traquito/traquito.github.io/README.md

### This is the repo for the Traquito website

You probably want to look at the website instead of the repo -- https://traquito.github.io

\
\
\
\
\
&nbsp;

#### Note -- No license available

You may use/copy the resources explicitly offered (eg hardware design files, .uf2 firmware), but the contents of this repo are not available for licensing and may not be used without written permission.
