traquito/traquito.github.io/docs/pro/telemetry/extended/playground/README.md

---
icon: material/seesaw
---

# Extended Telemetry Playground

<!DOCTYPE html>
<html>
  <head>
    <meta http-equiv="refresh" content="0; url='/pro/codec" />
  </head>
</html>
