traquito/traquito.github.io/docs/search/spots/dashboard/example/README.md

---
icon: material/map-search-outline
---

# Spot Search Example

<!DOCTYPE html>
<html>
  <head>
    <meta http-equiv="refresh" content="0; url='/search/spots/dashboard/?band=20m&channel=269&callsign=KD2KDD&limit=2000&dtGte=2023-05-08&dtLte=2023-06-01'" />
  </head>
</html>
