traquito/traquito.github.io/docs/updates/index.md

---
icon: material/new-box
---

# Updates
