traquito/traquito.github.io/docs/pro/query/REDIRECT.md

---
icon: material/database-search

hide:
  - toc
---

# Query wspr.live

<!DOCTYPE html>
<html>
  <head>
    <meta http-equiv="refresh" content="0; url='/pro/query'" />
  </head>
</html>
