traquito/traquito.github.io/docs/updates/posts/2023-07-17_19-18-01/2023-07-17_19-18-01.md

---
date:
  created: 2023-07-17

categories:
  - converted
  - site
---

# Better and new graphs, more flight info

!!! note "This entry is based on a converted groups.io post, put here for any documentation value."

Hi,

Minor updates to the website, mostly about graphing.

<strong>Graphs are easier to zoom in/out:</strong>

Just put your mouse over the chart, scroll up to zoom in, scroll down to zoom out, click+drag to pan left or right.

The x-axis automatically adapts to the zoom level.

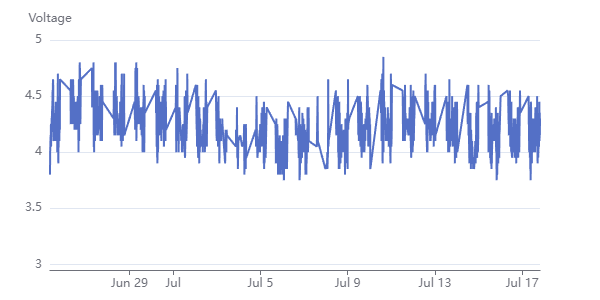
[picture p69: docs/updates/posts/2023-07-17_19-18-01/attach_0_1772D4B480047465_24843.png]


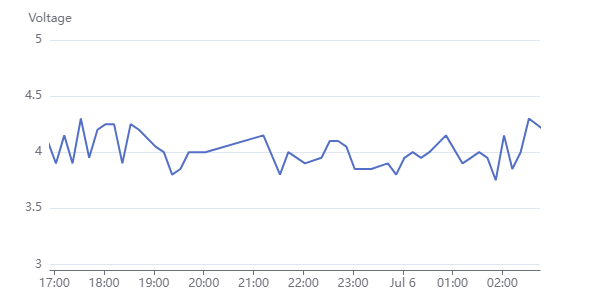
[picture p70: docs/updates/posts/2023-07-17_19-18-01/attach_1_1772D4B48007C552_24843.png]


<strong>Graphs show tooltips with both metric and imperial (and no more double-lines):</strong>

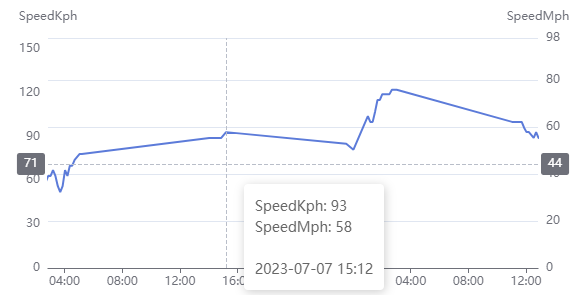
[picture p71: docs/updates/posts/2023-07-17_19-18-01/attach_2_1772D4B48021F60F_24843.png]


<strong>Experimental Graphs (only one for now):</strong>

Underneath the regular graphs is a new expandable section.



At the moment it has a user-configurable scatterplot that lets you (say) compare the temperature to reported voltage.

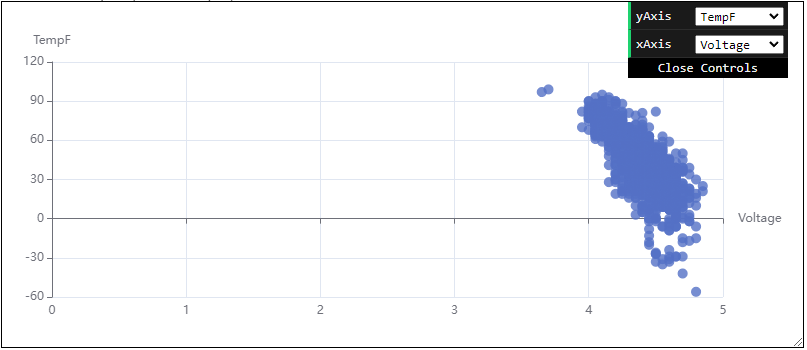
[picture p72: docs/updates/posts/2023-07-17_19-18-01/attach_4_1772D4B4802DD230_24843.png]


You can compare any measurement to any other measurement, however, and the graph just updates its view.

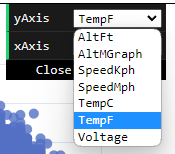
[picture p73: docs/updates/posts/2023-07-17_19-18-01/attach_5_1772D4B48039D973_24843.png]


Here are two searches that have relatively long histories that may be interesting to look at:

<ul>

<li>(<a href="https://traquito.github.io/search/spots/dashboard/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" target="_blank" rel="noopener">link</a>) K6STS</li>

<li>(<a href="https://traquito.github.io/search/spots/dashboard/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" target="_blank" rel="noopener">link</a>) WD0HXN</li>

</ul>

I didn't want to burden the typical page viewer with too much information, but happy to take feedback about what is/isn't useful to see.

<strong>The graphs are much faster to load and snappier to use.</strong>

Can't take a screenshot of that but the page hopefully feels even zippier.

<strong>Info section has more info</strong>

A few additional stats got added.

Flight duration just does the math for you by looking at the earliest and latest spot in your search and working out the difference.



Thanks.

Doug
