traquito/traquito.github.io/docs/README.md

---
icon: material/home

hide:
  - toc
---

# Traquito WSPR Pico Balloon Resources

<div class="grid cards" markdown>

- <a class="card" href="./tracker/">
    <figure markdown="span">
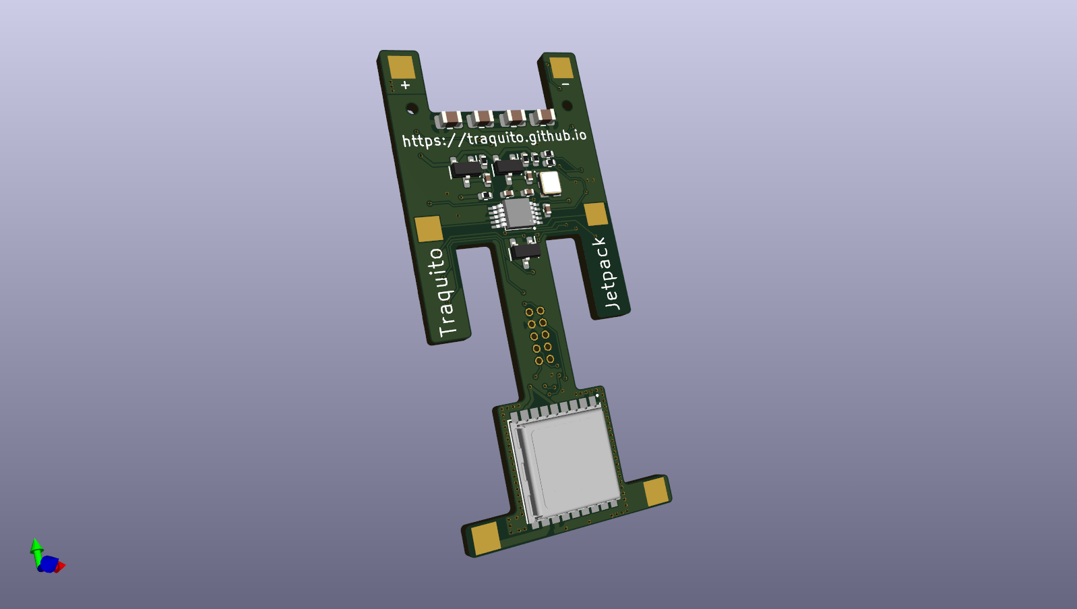
[picture p80: docs/img/tracker.png]
        
        <figcaption>Jetpack WSPR Tracker</figcaption>
    </figure>
  </a>

- <a class="card" href="./solar/">
    <figure markdown="span">
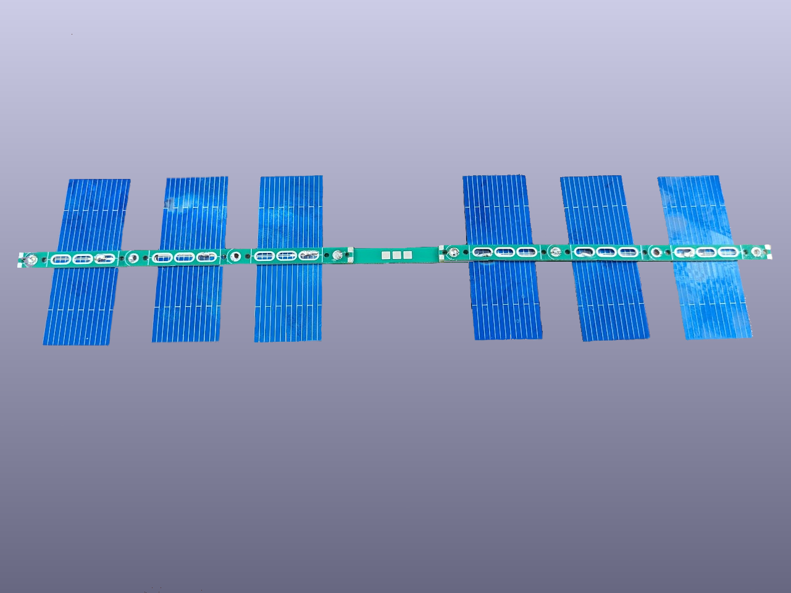
[picture p81: docs/solar/solar.png]
        
        <figcaption>Solar System</figcaption>
    </figure>
  </a>

- <a class="card" href="./search/spots/dashboard/example/" target="_blank">
    <figure markdown="span">
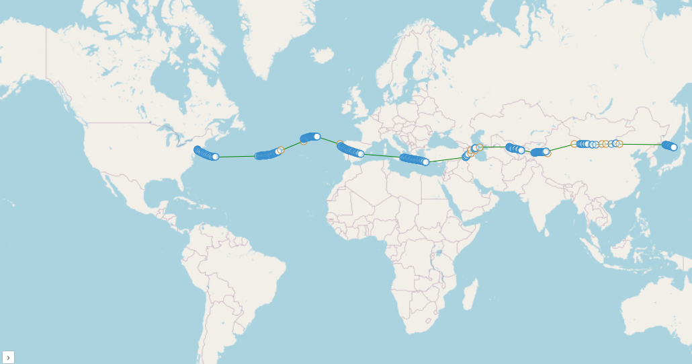
[picture p82: docs/img/spotsearch.png]
        
        <figcaption>Spot Search</figcaption>
    </figure>
  </a>

- <a class="card" href="./channelmap/">
    <figure markdown="span">
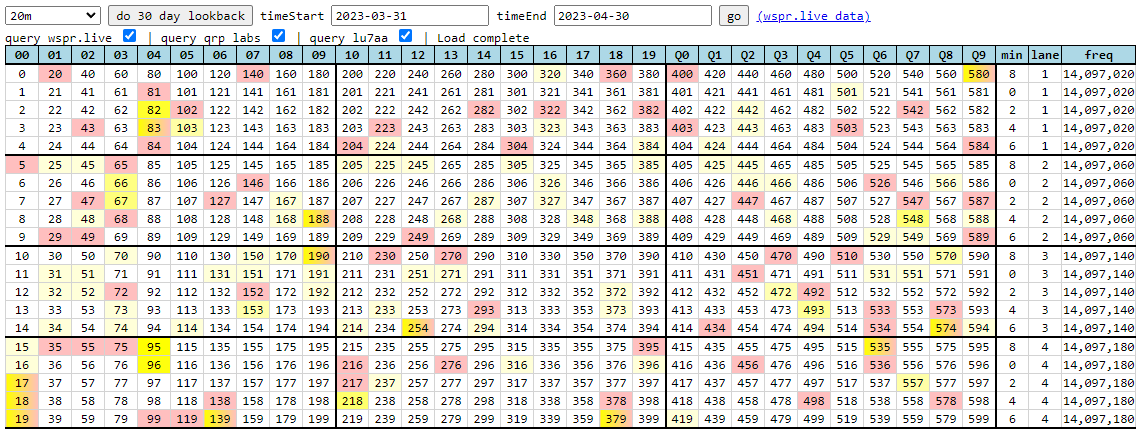
[picture p83: docs/img/channelmap.png]
        
        <figcaption>Channel Map</figcaption>
    </figure>
  </a>

- <a class="card" href="./trackergui/">
    <figure markdown="span">
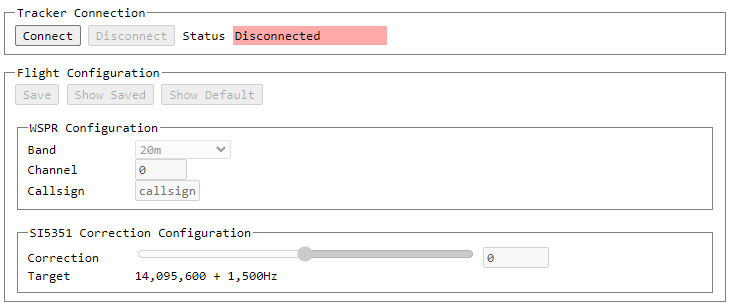
[picture p84: docs/img/trackergui.png]
        
        <figcaption>Tracker GUI</figcaption>
    </figure>
  </a>

- <a class="card" href="./WOM5000/">
    <figure markdown="span">
        
        <figcaption>Wind-O-Matic 5000</figcaption>
    </figure>
  </a>

- <a class="card" href="./pro/">
    <figure markdown="span">
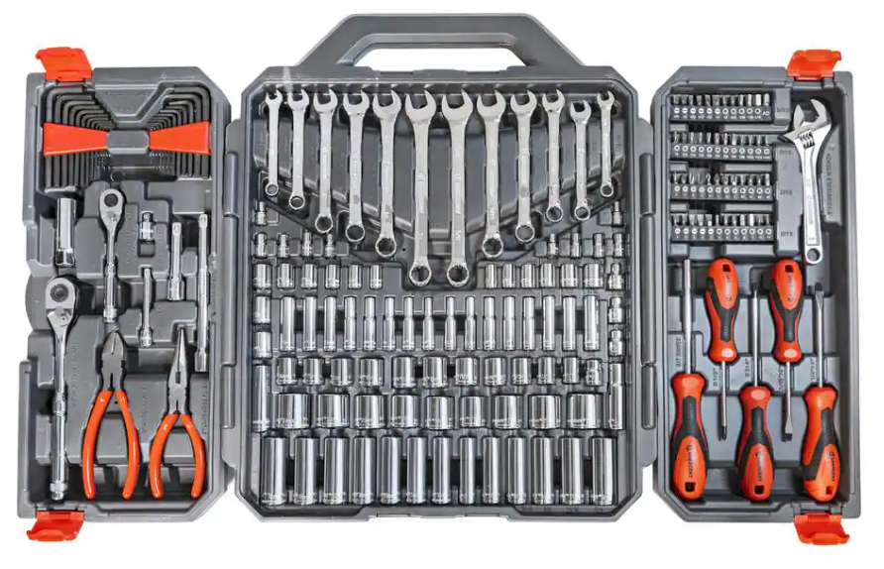
[picture p85: docs/img/protools.png]
        
        <figcaption>Pro Tools</figcaption>
    </figure>
  </a>

- <a class="card" href="./updates/">
    <figure markdown="span">
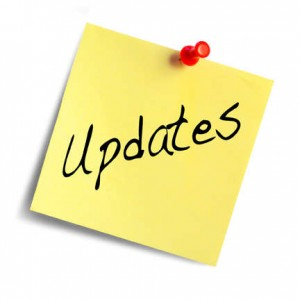
[picture p86: docs/updates/card.jpg]
        
        <figcaption>Updates</figcaption>
    </figure>
  </a>

- <a class="card" href="./faq/">
    <figure markdown="span">
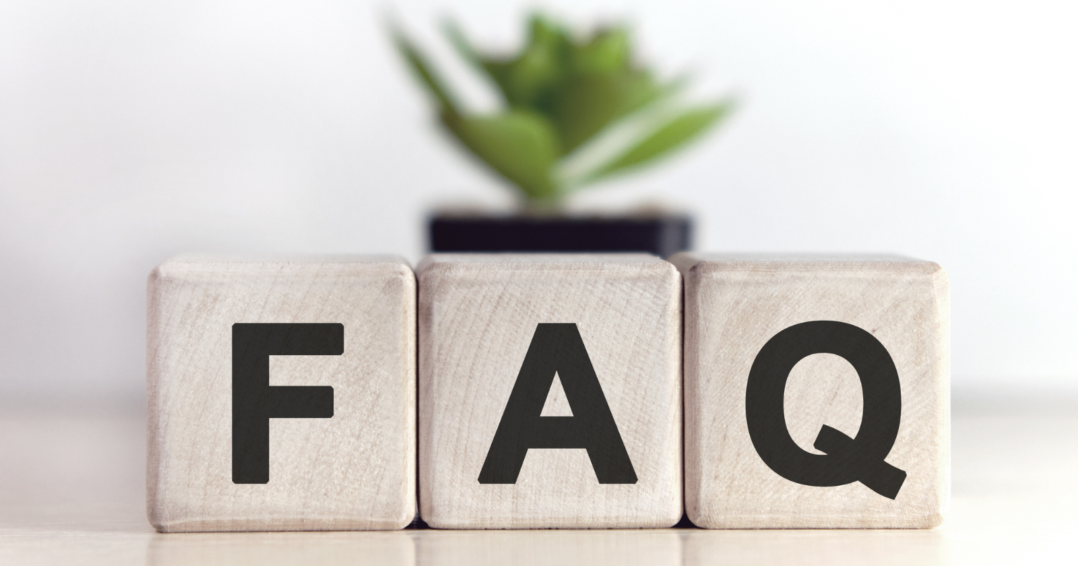
[picture p87: docs/img/faq.png]
        
        <figcaption>FAQ</figcaption>
    </figure>
  </a>

</div>
