traquito/traquito.github.io/docs/pro/README.md

---
icon: material/professional-hexagon

hide:
  - toc
---

# Pro Tools

<div class="grid cards" markdown>

- <a class="card" href="./decode/">
    <figure markdown="span">
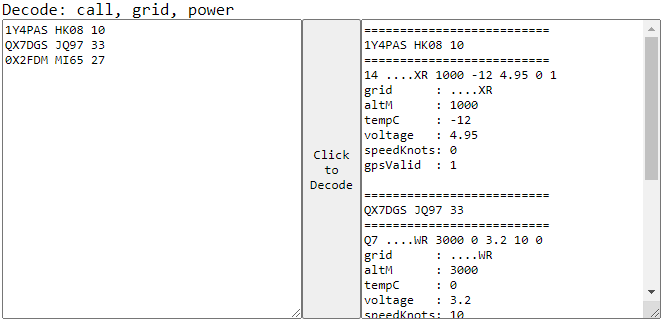
[picture p88: docs/pro/decode/decode.png]
        
        <figcaption>Decode</figcaption>
    </figure>
  </a>

- <a class="card" href="./query/">
    <figure markdown="span">
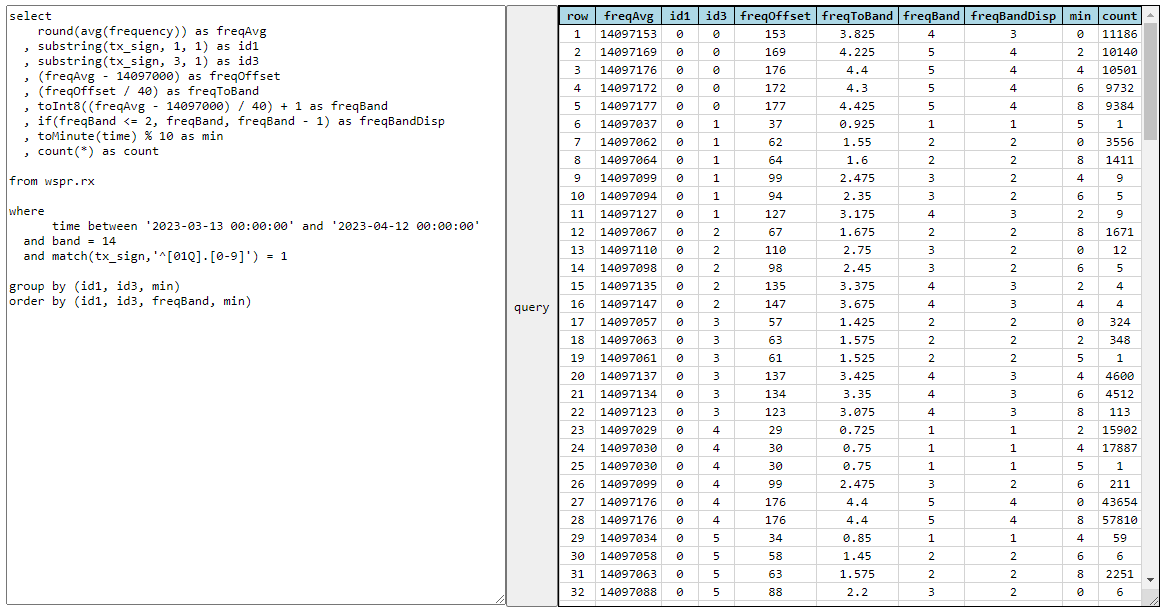
[picture p89: docs/pro/query/query.png]
        
        <figcaption>Query</figcaption>
    </figure>
  </a>

- <a class="card" href="./apimode/">
    <figure markdown="span">
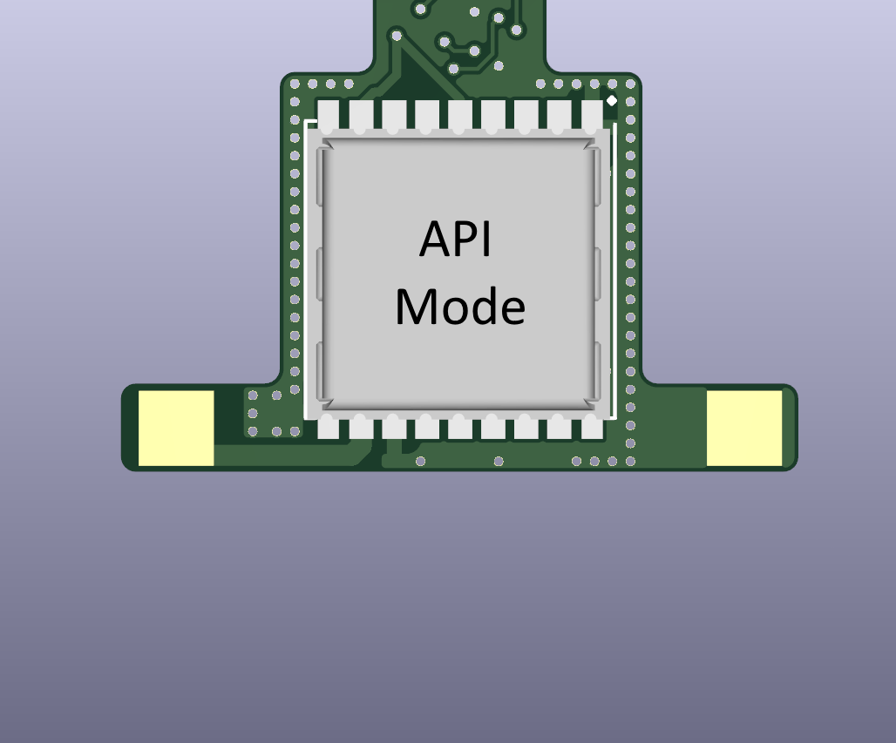
[picture p90: docs/pro/apimode/apimode.png]
        
        <figcaption>API Mode</figcaption>
    </figure>
  </a>

- <a class="card" href="./trackerhacker/">
    <figure markdown="span">
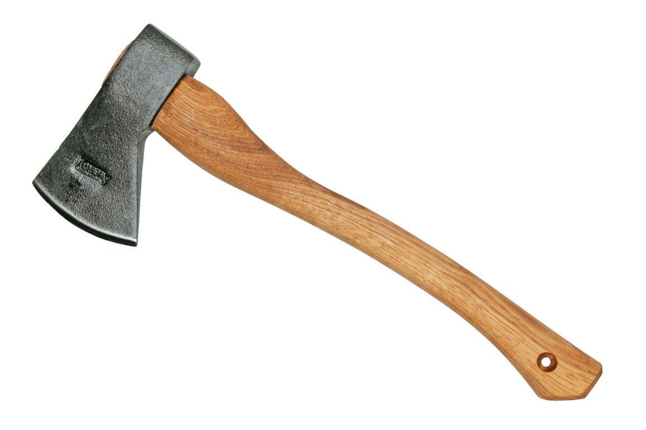
[picture p91: docs/pro/trackerhacker/trackerhacker.png]
        
        <figcaption>Tracker Hacker</figcaption>
    </figure>
  </a>

- <a class="card" href="./telemetry/">
    <figure markdown="span">
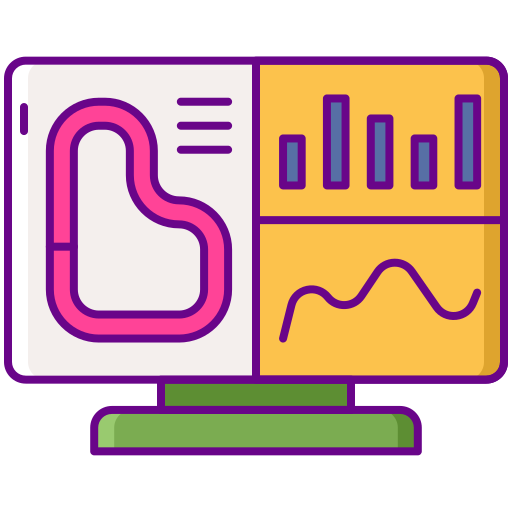
[picture p92: docs/pro/telemetry/card.png]
        
        <figcaption>WSPR Telemetry</figcaption>
    </figure>
  </a>

</div>
