traquito/traquito.github.io/docs/updates/posts/2023-11-12_12-02-10/2023-11-12_12-02-10.md

---
date:
  created: 2023-11-12

categories:
  - converted
  - site
---

# Jump between map and data

!!! note "This entry is based on a converted groups.io post, put here for any documentation value."

Hi, a few new features to mention.

It's all about page interactivity.

<strong><span style="text-decoration: underline;">Focus the map from the graph</span></strong>

When you hover over a graph, you see a tooltip showing you the date/time of where your cursor is.

Now, when you click any graph at a given time, the map will center on that spot and pop-up the info dialog.

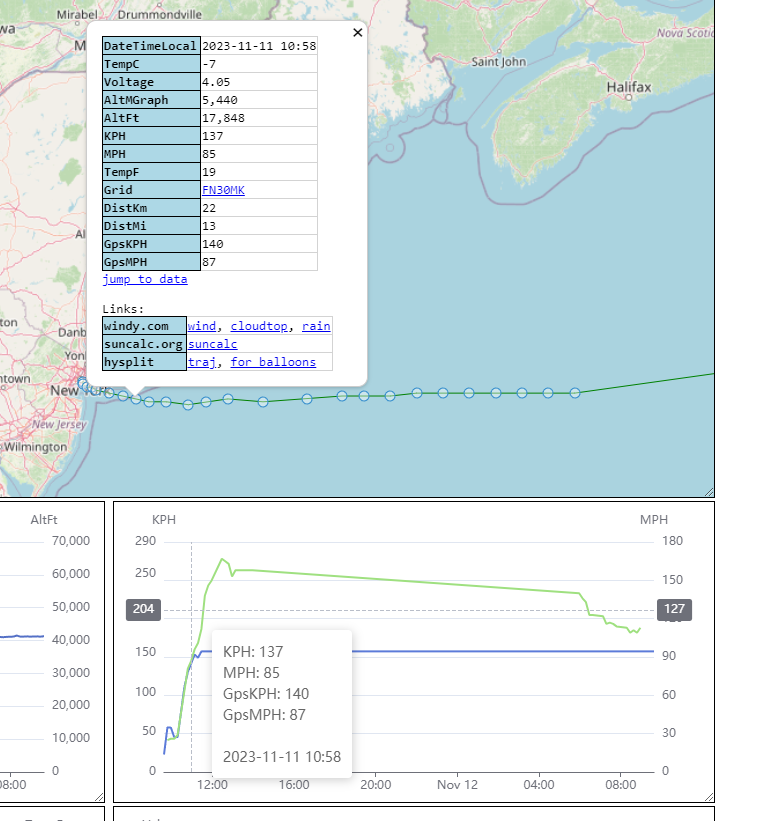
[picture p108: docs/updates/posts/2023-11-12_12-02-10/attach_0_1796F8ACF072FA6D_7701.png]


<strong><span style="text-decoration: underline;">Focus the map from data</span></strong>

A new "Map" column has been added with a link per-row.

Click the link, and the page will jump to the map, and the map will center on that spot and pop-up the info dialog.

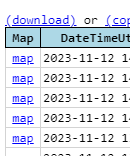
[picture p109: docs/updates/posts/2023-11-12_12-02-10/attach_1_1796F8ACF07C3EBF_7701.png]


<strong><span style="text-decoration: underline;">Jump to data from map</span></strong>

A new "jump to data" link is visible in the map spot pop-up.

Click the link, and the page will jump to the data.



<strong><span style="text-decoration: underline;">Generally</span></strong>

The idea is that it can be hard to look at data and find the corresponding map location, and vise versa, especially when looking at long flights.

Hopefully this makes exploring the data a little easier.

Example long flight:

<a href="https://traquito.github.io/search/spots/dashboard/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" target="_blank" rel="noopener">https://traquito.github.io/search/spots/dashboard/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</a>

Thanks.

Doug
