traquito/traquito.github.io/docs/updates/posts/2024-02-20_11-08-56/2024-02-20_11-08-56.md

---
date:
  created: 2024-02-20

categories:
  - converted
  - site
---

# Toggle map lines

Update,

Map now allows you to turn on/off the lines connecting spots.

Toggled on:

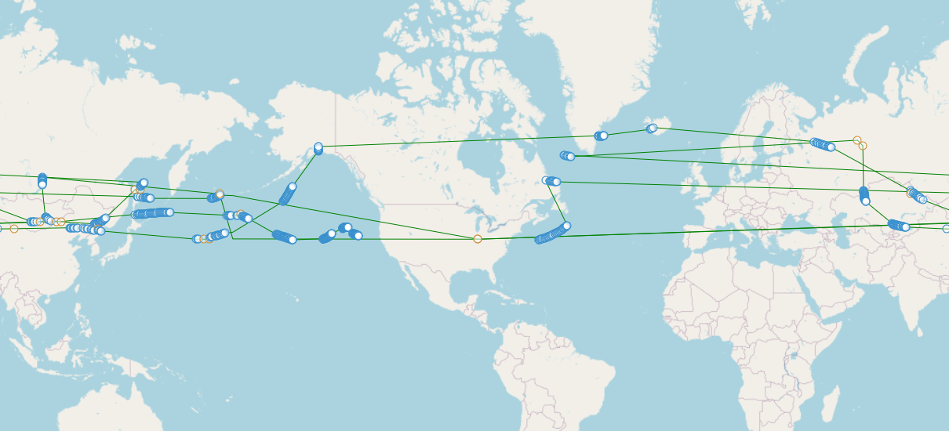
[picture p112: docs/updates/posts/2024-02-20_11-08-56/image.png]


Toggled off:

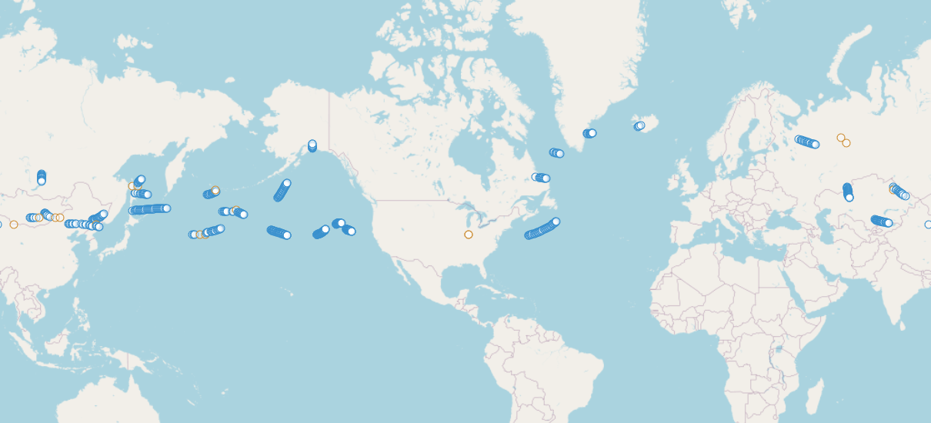
[picture p113: docs/updates/posts/2024-02-20_11-08-56/image-1.png]


The toggle is the "L" button in the upper-right hand corner.



This is based on the request from John about his flight (pictured above, linked [here](https://traquito.github.io/search/spots/dashboard/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)) having long durations of missing data, and the lines connecting them making the path appear incorrect.

The logic for lines is just "connect the dots."  When there are many missing data points, this can lead to the situation above.

Thanks.

Doug
