traquito/traquito.github.io/site/channelmap/help/channels.png

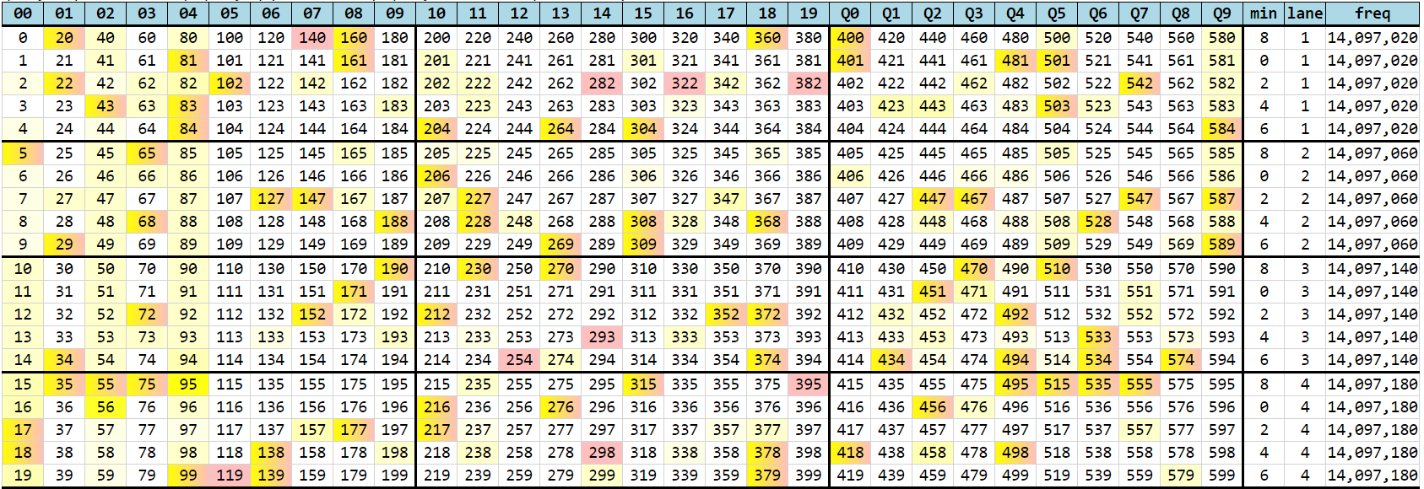
site/channelmap/help/channels.png
