traquito/traquito.github.io/site/pro/trackerhacker/side_by_side.png

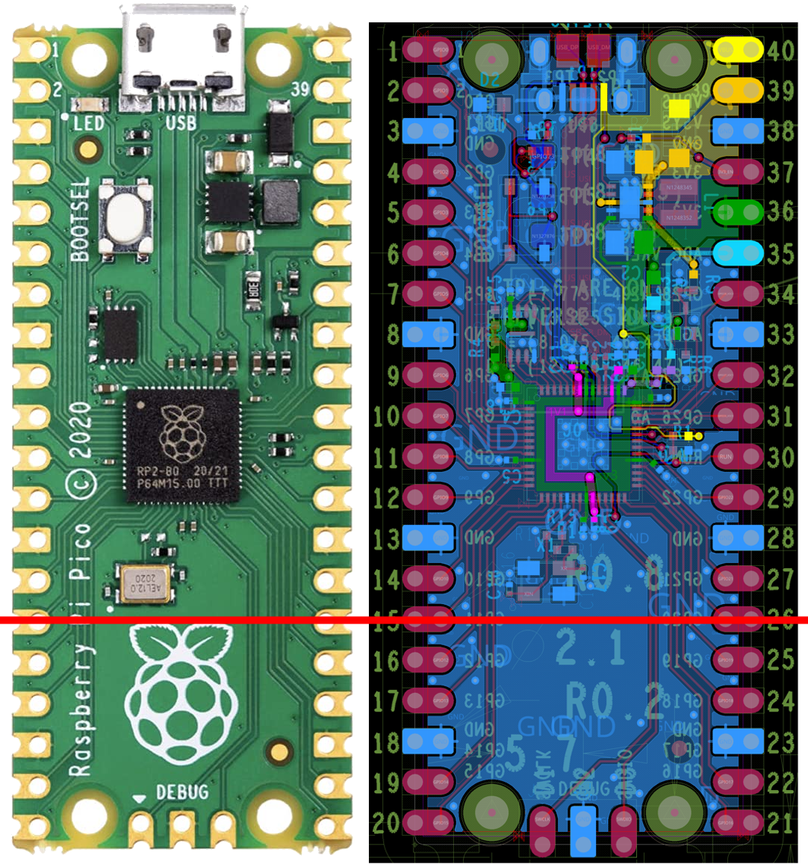
site/pro/trackerhacker/side_by_side.png
