traquito/traquito.github.io/site/solar/battery.png

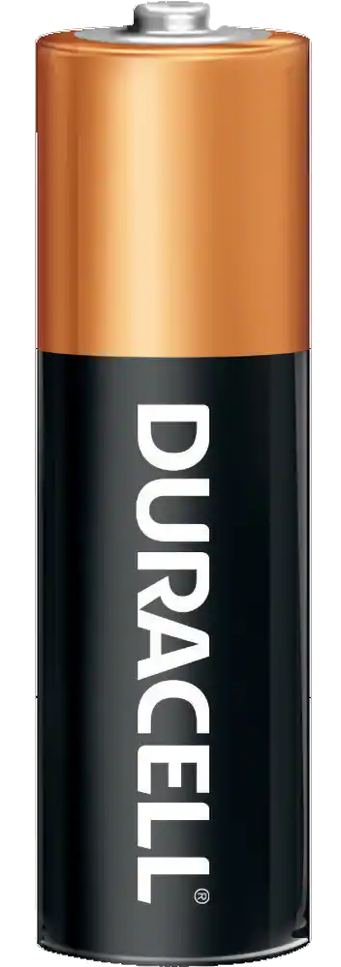
site/solar/battery.png
