traquito/traquito.github.io/site/solar/ss_cells_in_series_bottom.png

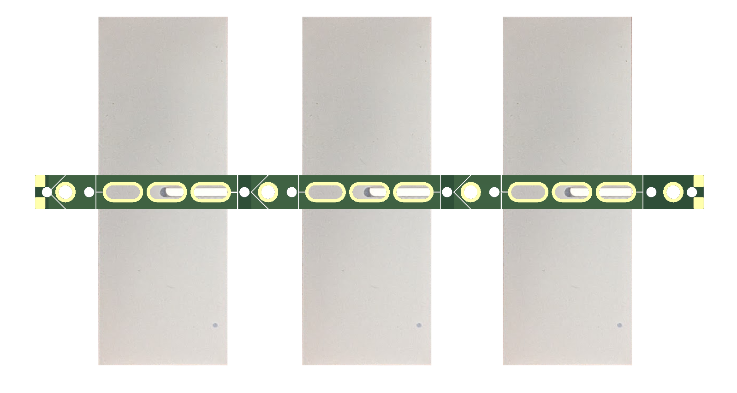
site/solar/ss_cells_in_series_bottom.png
