traquito/traquito.github.io/site/tracker/V1/files/placement.png

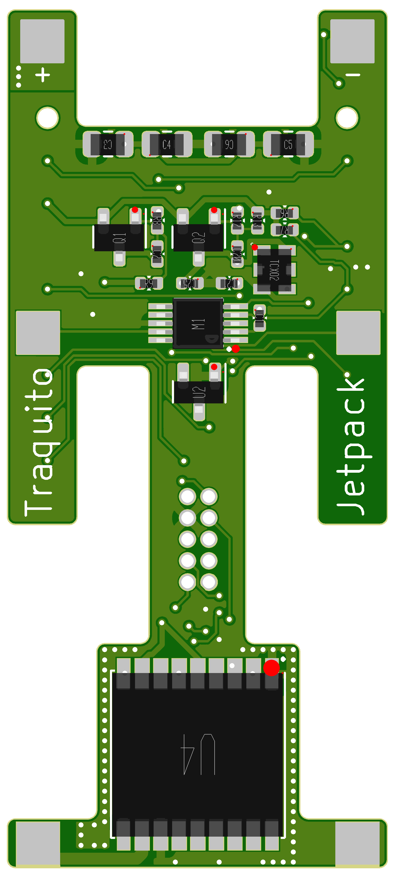
site/tracker/V1/files/placement.png
