traquito/traquito.github.io/site/trackergui/warning.png

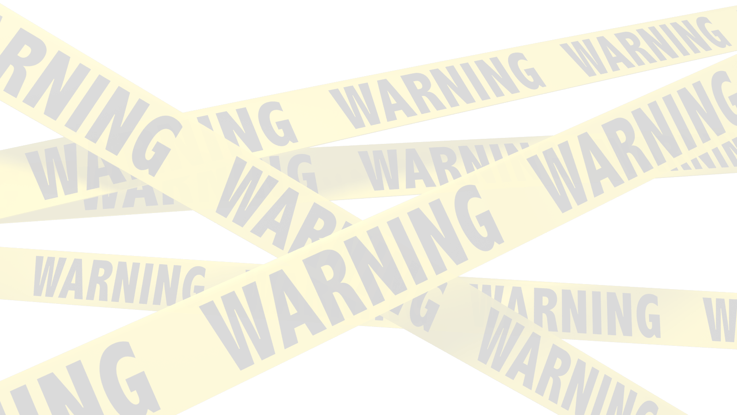
site/trackergui/warning.png
