traquito/traquito.github.io/site/updates/2024-11-30/image-5.png

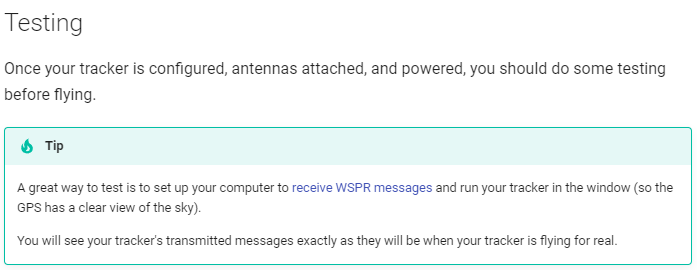
site/updates/2024-11-30/image-5.png
