traquito/traquito.github.io/site/updates/2024-11-30/image-7.png

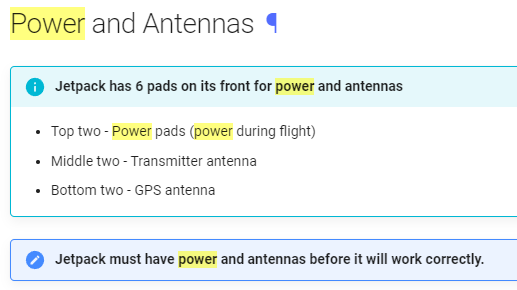
site/updates/2024-11-30/image-7.png
