traquito/traquito.github.io/site/WOM5000/circuit_fritzing.png

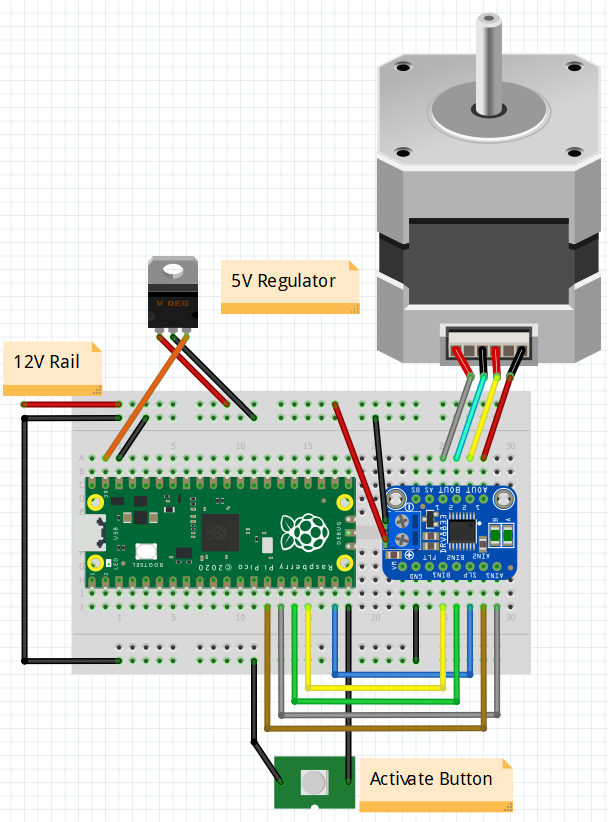
site/WOM5000/circuit_fritzing.png
