traquito/traquito.github.io/site/solar/Solar_System_Soldering_Jig_2024-01-01.stl

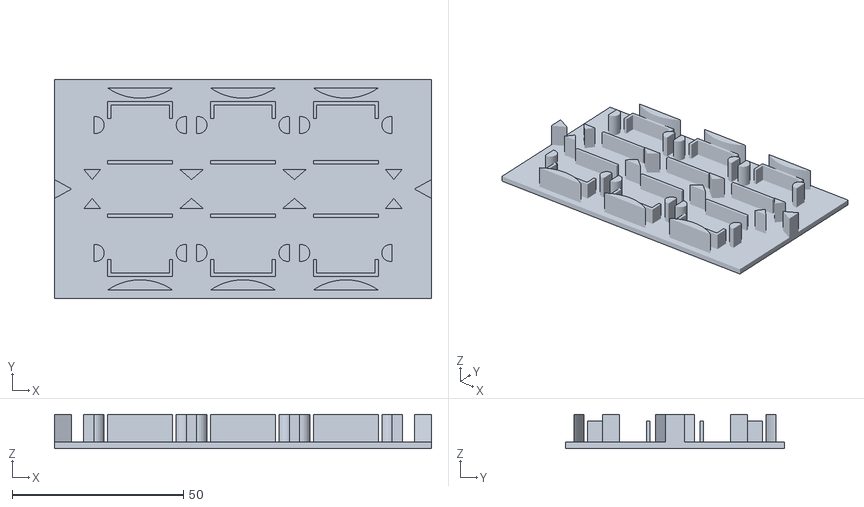
[picture p138: CAD file, 2024-01-01]
site/solar/Solar_System_Soldering_Jig_2024-01-01.stl
110.0 x 64.0 x 10.0
