traquito/traquito.github.io/site/WOM5000/WOM5000.drum.2024-01-30.3mf

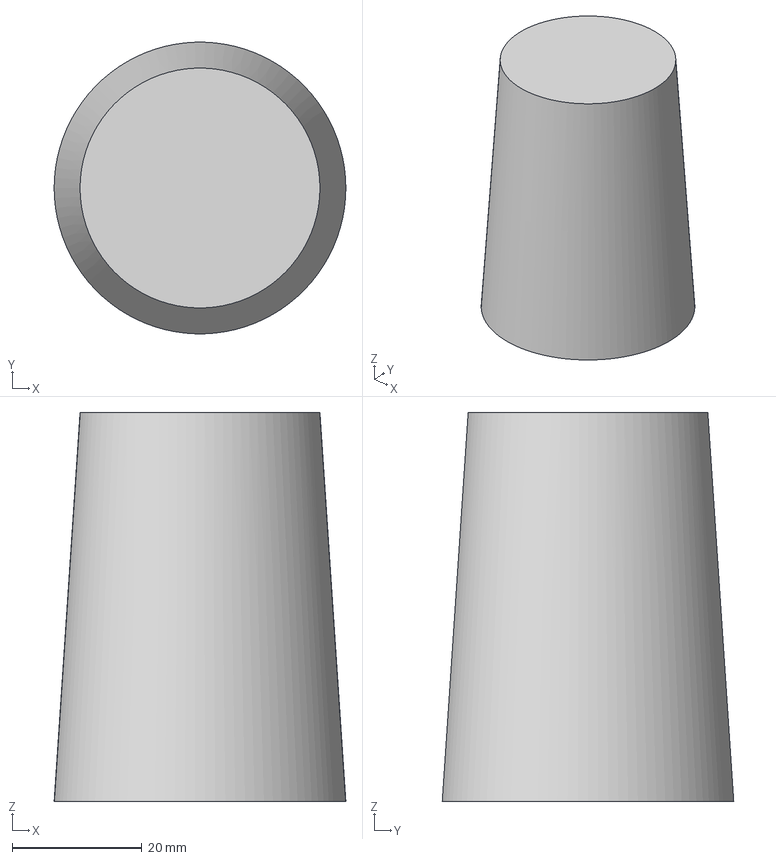
[picture p139: CAD file, 2024-01-30]
site/WOM5000/WOM5000.drum.2024-01-30.3mf
45.0 x 45.0 x 60.0 mm
