traquito/traquito.github.io/site/WOM5000/WOM5000.platform.2024-01-30.3mf

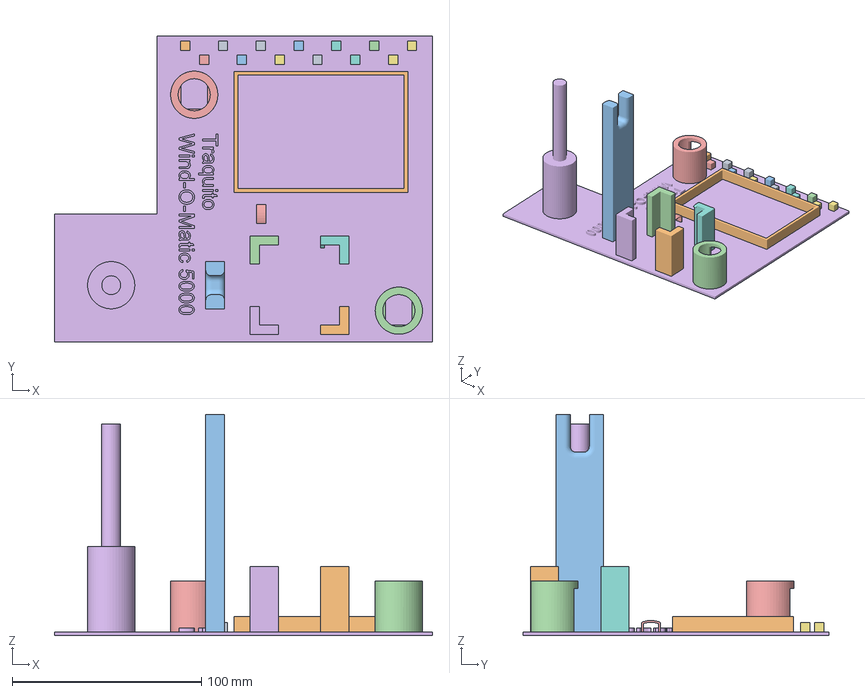
[picture p140: CAD file, 2024-01-30]
site/WOM5000/WOM5000.platform.2024-01-30.3mf
200.0 x 161.8 x 117.0 mm
