traquito/traquito.github.io/docs/faq/jlcpcb/README.md

---
icon: material/chip
---

# Ordering from JLCPCB Instructions

## Ordering from JLCPCB

[jlcpcb.com](https://jlcpcb.com/) fabricates PCBs and assembles them as well, meaning they can produce a fully-populated PCB, shipped directly to you.

The [Traquito Jetpack](../../tracker/README.md#hardware-design-file-downloads) tracker Add-on Module is available to you directly through this service.

There are 3 files you will need to provide to JLCPCB during the ordering process.  You don't need to know anything about these files, just submit them and JLCPCB will take care of the rest.

A walkthrough of how to order is presented below.

!!! info "The set of files used for ordering"
    - BOM ("bill of materials" aka list of parts)
    - CPL part placement file (describes where each component should be placed/soldered on the PCB)
    - Gerber files in a .zip (describes the PCB itself - track location, shape of board, etc)

!!! warning
    The steps below should "just work."

    If you find yourself having to do something unexpected to "get it to work" then something is probably wrong.  Please reach out for help!

!!! tip
    Make sure you have an account created, and that you're logged in, before beginning.

!!! note
    Also, note that JLCPCB sometimes shows the PCB outline as a rectangle, depending on a bug on their side.
    
    The order is fine, though, this is known and you can continue.

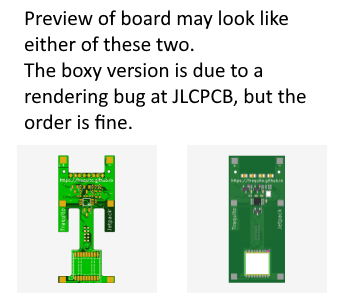
[picture p142: docs/faq/jlcpcb/render_bug.png]
    

### Step 1

[jlcpcb.com](https://jlcpcb.com/)

Drag the gerber zip file onto the circled target on the JLCPCB site.

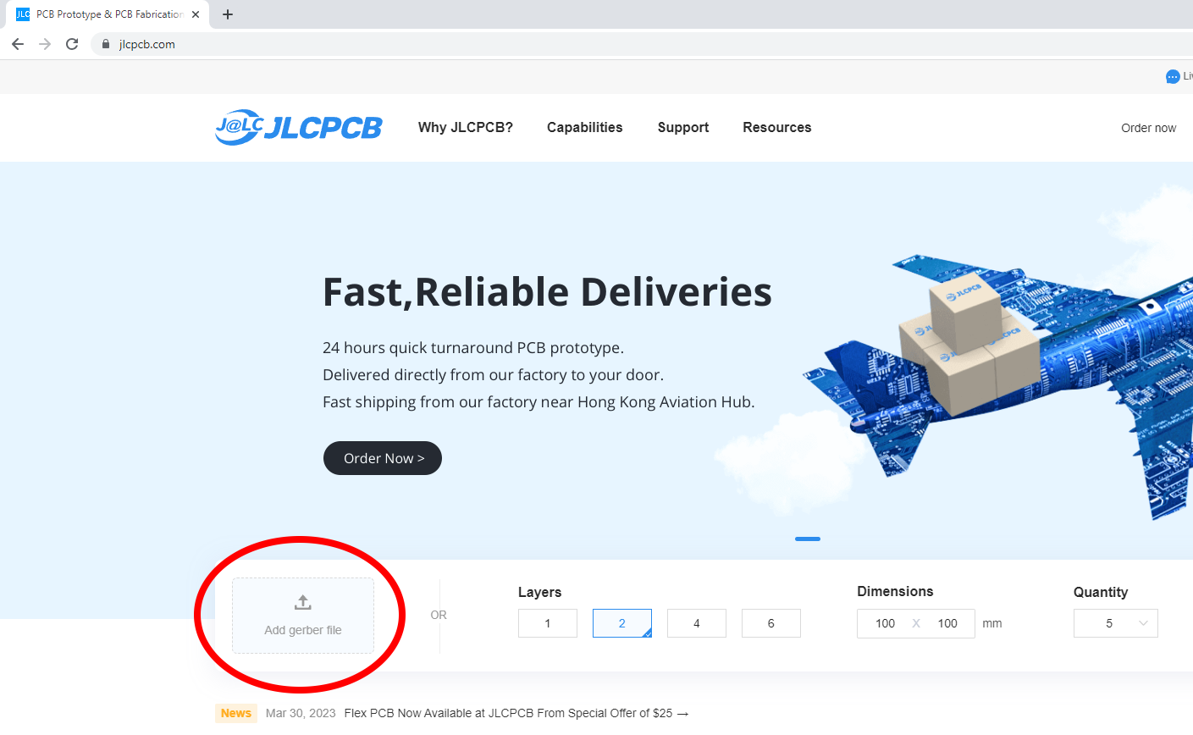
[picture p143: docs/faq/jlcpcb/step1.png]


### Step 2

This page appears and is mostly defaulted correctly.

You only need to change the parts highlighted in red.

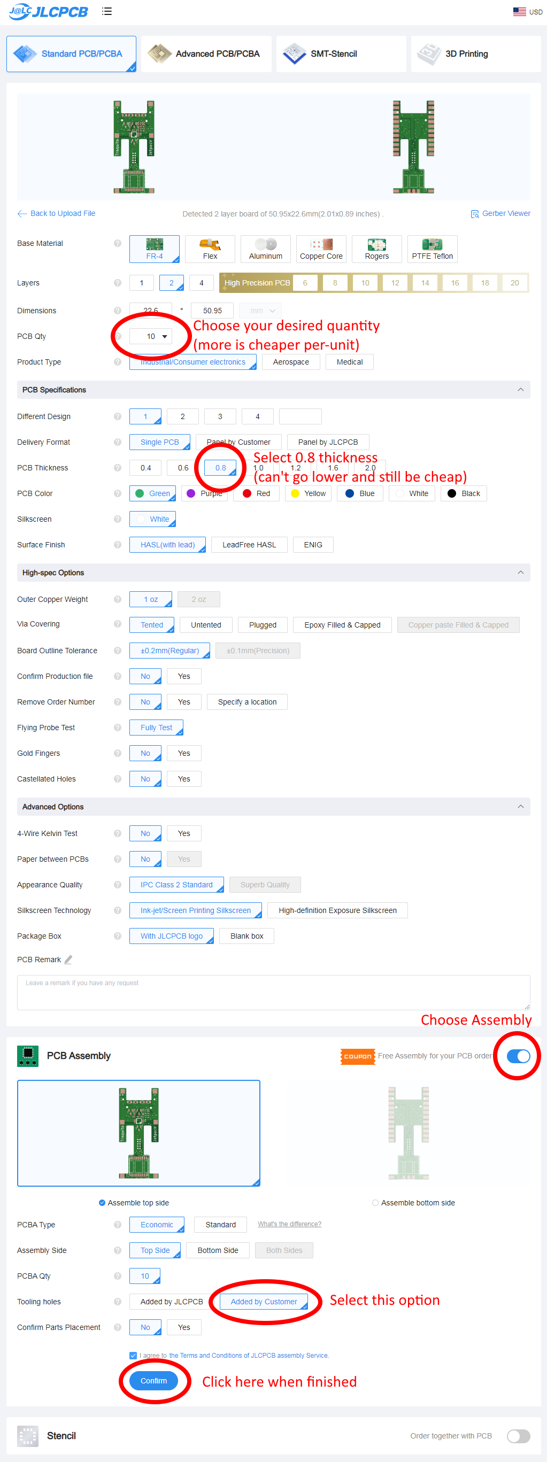
[picture p144: docs/faq/jlcpcb/step2.png]


### Step 3

Click Next.

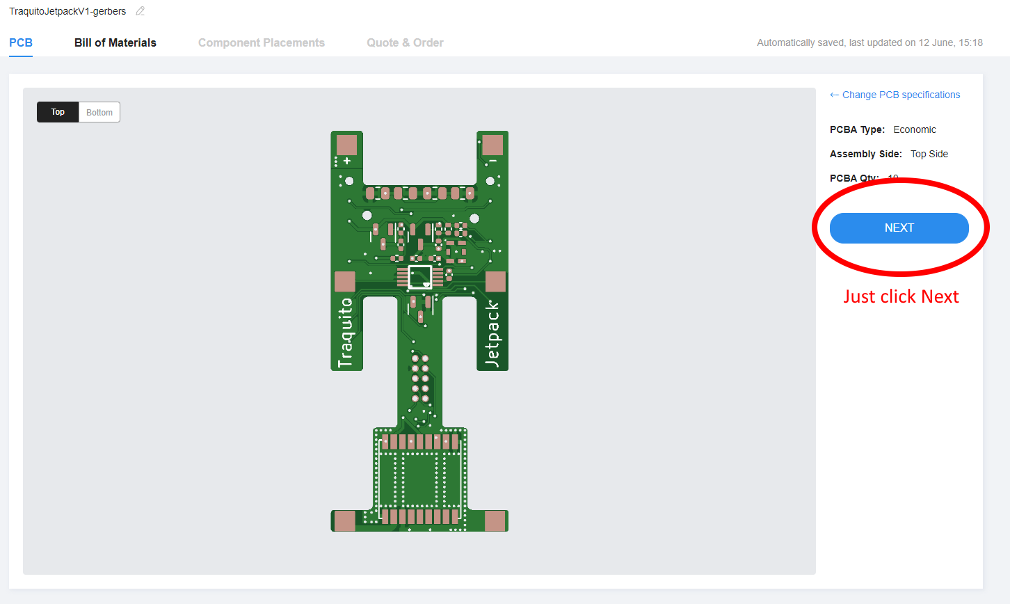
[picture p145: docs/faq/jlcpcb/step3.png]


### Step 4

Provide the BOM and placement files.

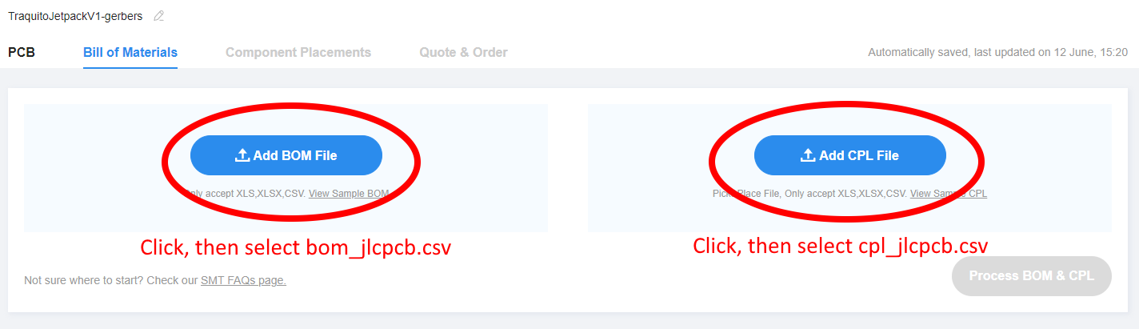
[picture p146: docs/faq/jlcpcb/step4.1.png]


Click to continue when ready.

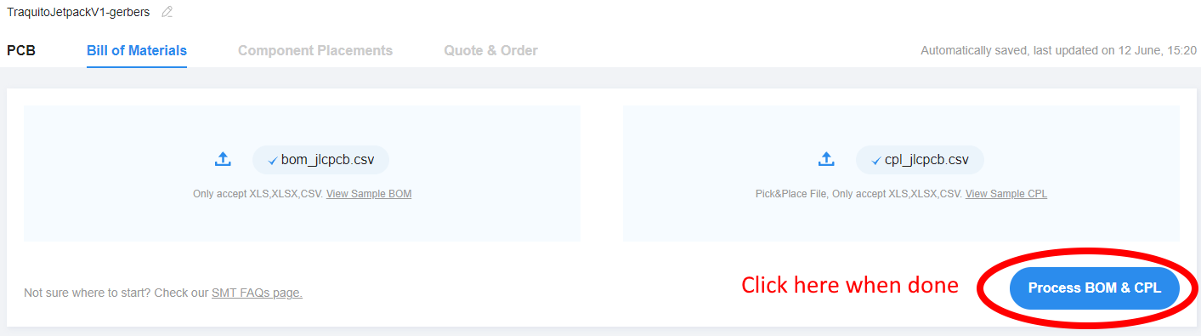
[picture p147: docs/faq/jlcpcb/step4.2.png]


### Step 5

Click Next.

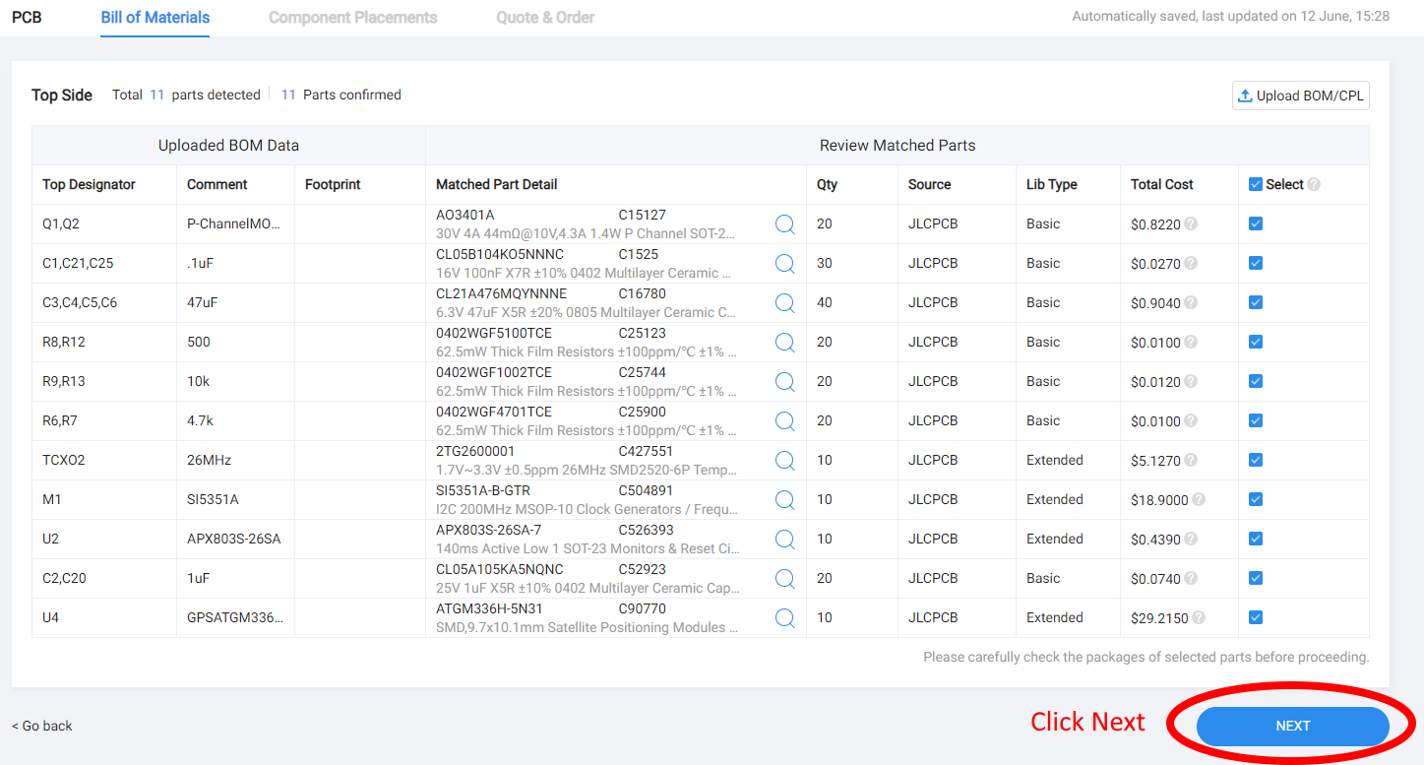
[picture p148: docs/faq/jlcpcb/step5.png]


It is possible one or more parts are out of inventory (a "shortfall").

!!! tip "You can preorder parts for next time if there is a shortfall"
    Click [here](./preorder/README.md) to learn how to preorder parts (no additional cost) to overcome this.
    
    You can also just check back later and hope there is more parts in the JLCPCB inventory.

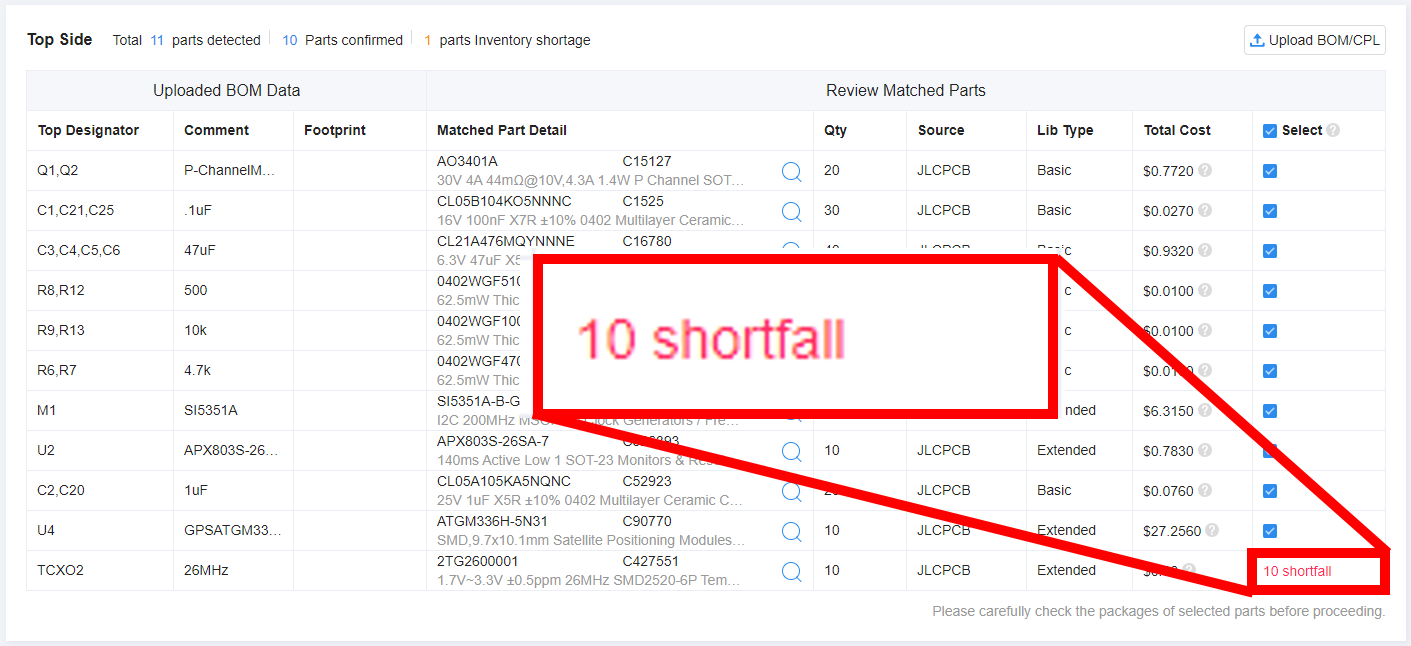
[picture p149: docs/faq/jlcpcb/preorder/shortfall.png]


### Step 6

Click Next.

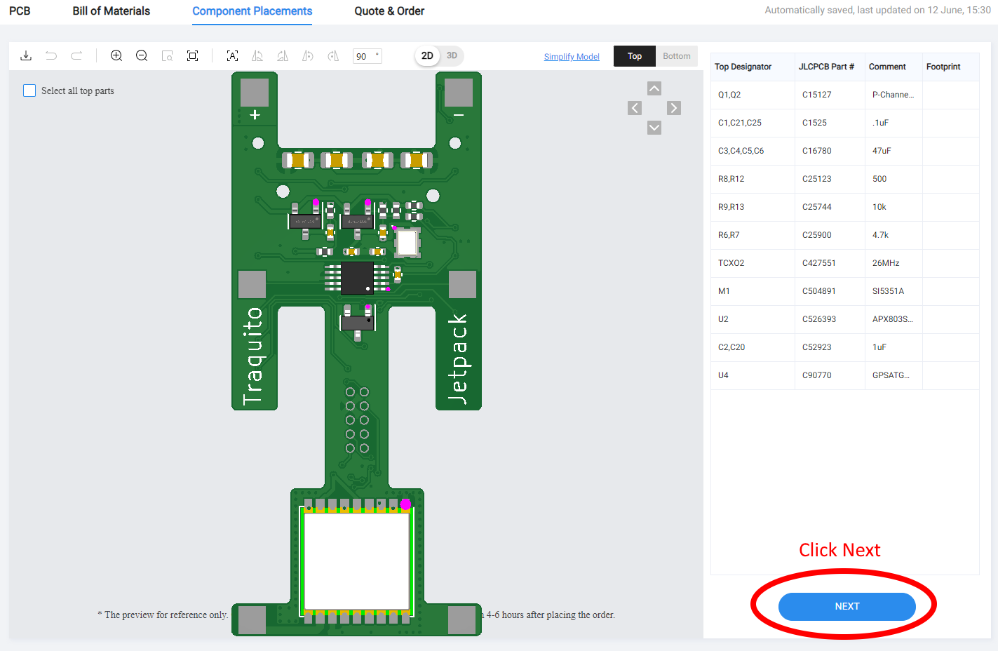
[picture p150: docs/faq/jlcpcb/step6.png]


### Step 7

You need to declare what type of board this is -- it's DIY.

Save to cart when done.

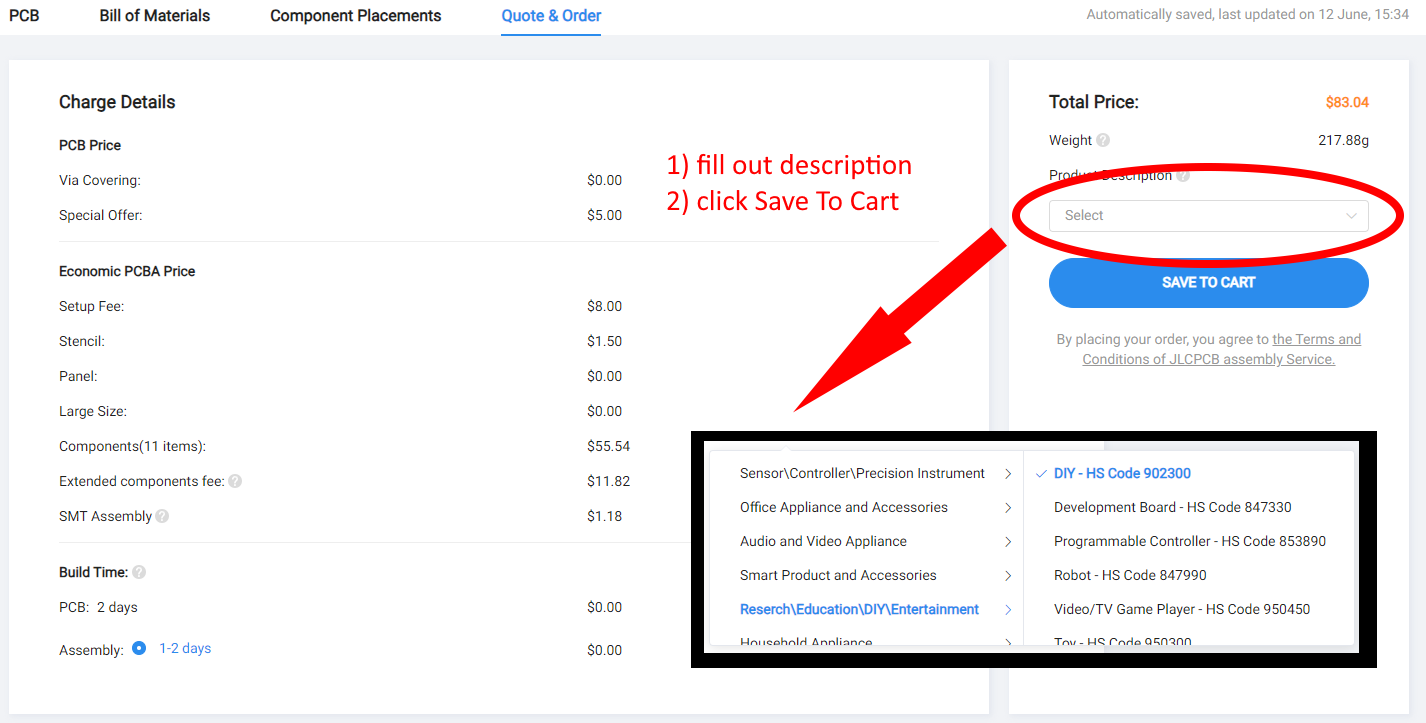
[picture p151: docs/faq/jlcpcb/step7.png]


### Step 8

Time to check out

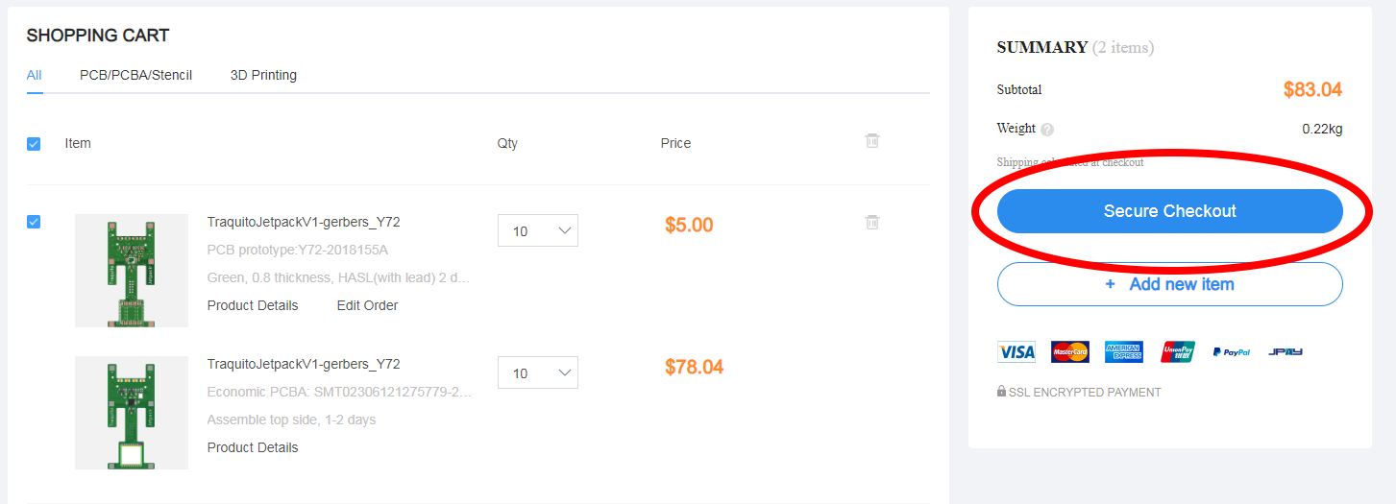
[picture p152: docs/faq/jlcpcb/step8.png]


### Step 9

The rest of the process is straightforward payment and shipping address setup.

A note about shipping methods -- they all basically cost the same (around $20).

The exception the "Global Standard Direct Line," which I have never used before.

DHL has done a great job every time.

I recommend just picking a typical carrier.

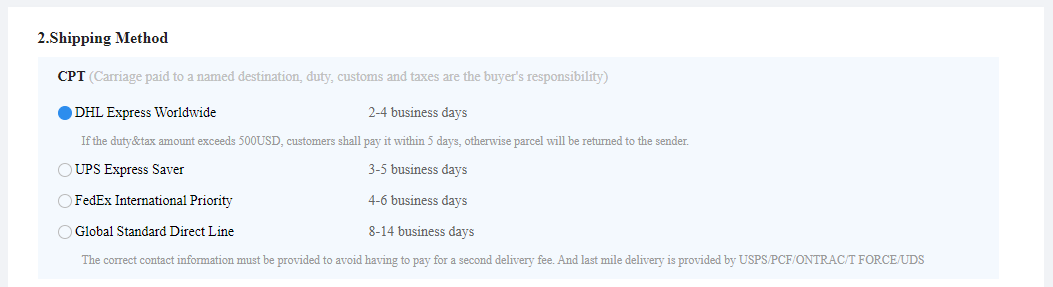
[picture p153: docs/faq/jlcpcb/step9.png]


## Re-Ordering in the future

In the future, if you want to order additional Add-on Modules, you can, without going through the whole process again.

Instead, first, go to the order history page

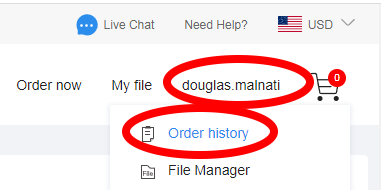
[picture p154: docs/faq/jlcpcb/reorder1.png]


Then, find the last order, and click Reorder to begin the process.

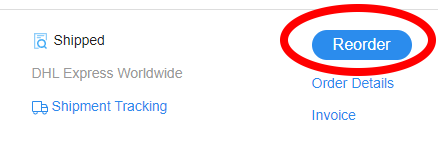
[picture p155: docs/faq/jlcpcb/reorder2.png]
