traquito/traquito.github.io/docs/faq/receiving/README.md

---
icon: material/signal-variant
---

# Receiving WSPR Messages

## Receiving WSPR Messages

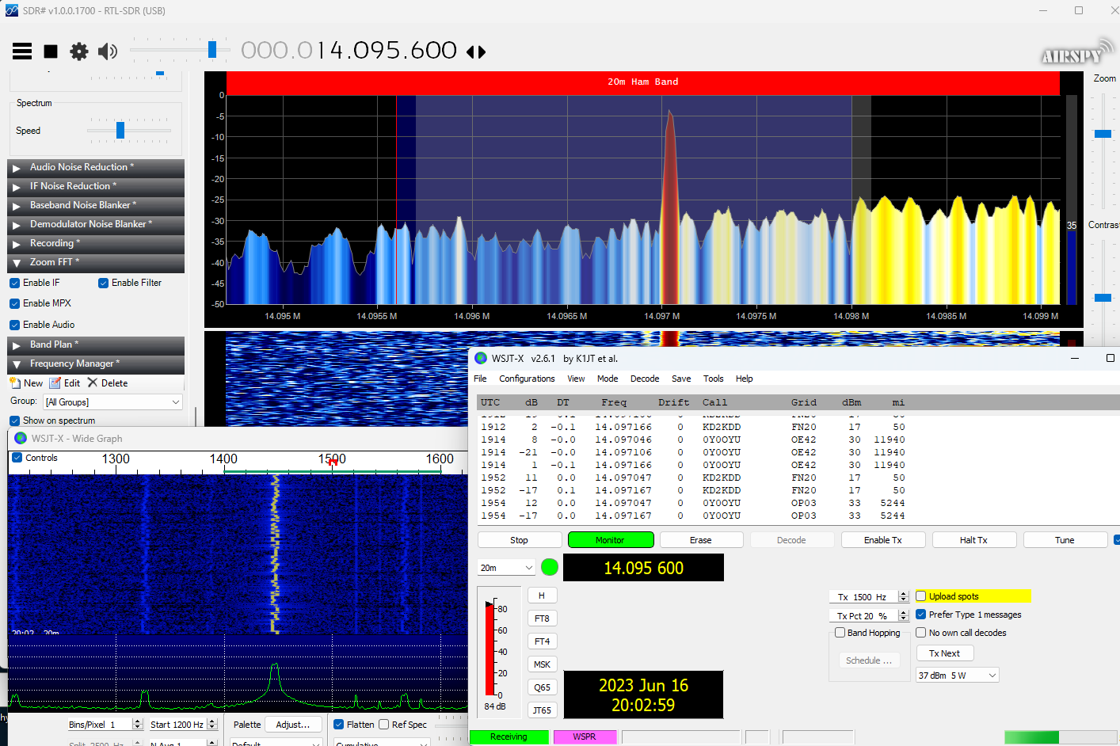
[picture p156: docs/faq/receiving/receiving.png]


Whether for testing your [tracker](../../tracker/README.md), or just the fun of receiving WSPR messages, this guide will get you set up.

[WSPR Setup Guide](https://docs.google.com/document/d/1H-smaTDMAI-xivRdf6qwDRPtaUUaPjmTi5TplS3l9pk)
