traquito/traquito.github.io/docs/faq/README.md

---
icon: material/frequently-asked-questions 

hide:
  - toc
---

# FAQ

<div class="grid cards" markdown>

- <a class="card" href="./about/">
    <figure markdown="span">
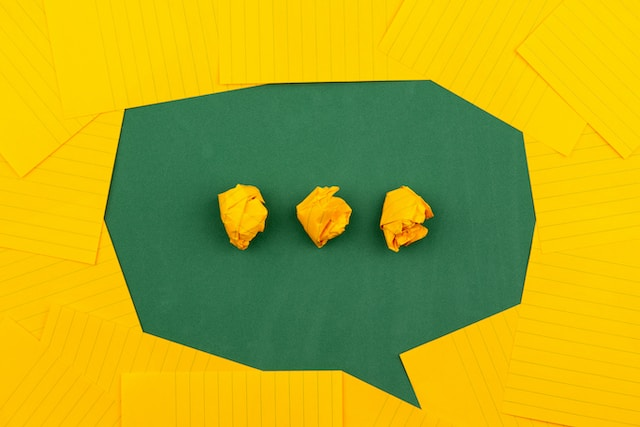
[picture p162: docs/faq/about/about.jpg]
        
        <figcaption>About</figcaption>
    </figure>
  </a>

- <a class="card" href="./bigidea/">
    <figure markdown="span">
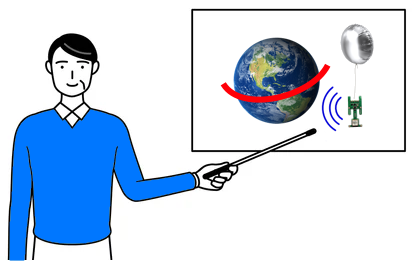
[picture p163: docs/faq/bigidea/bigidea.png]
        
        <figcaption>Big Idea</figcaption>
    </figure>
  </a>

- <a class="card" href="./sites/">
    <figure markdown="span">
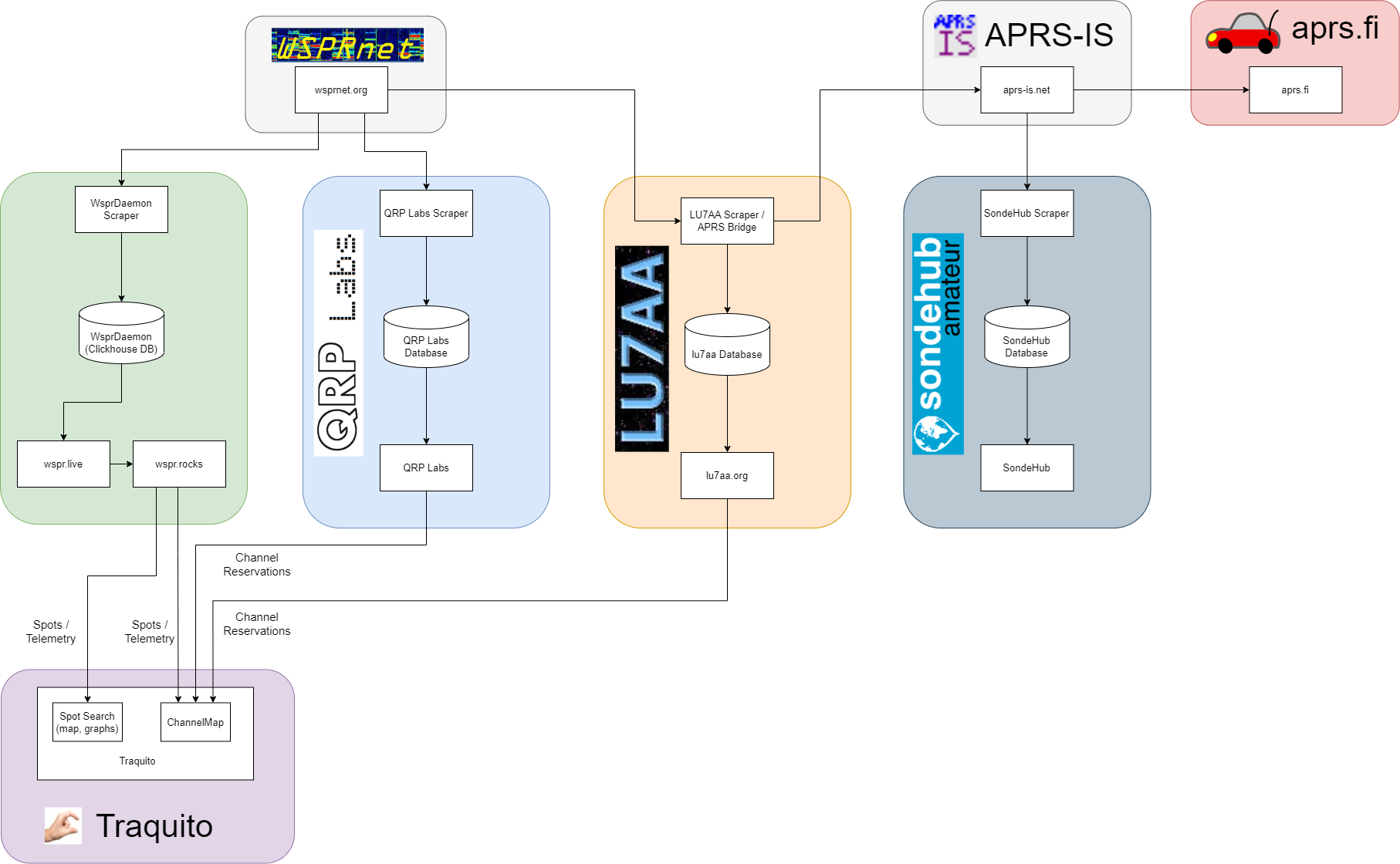
[picture p164: docs/faq/sites/wspr_site_relationships.png]
        
        <figcaption>WSPR Site Relationships</figcaption>
    </figure>
  </a>

- <a class="card" href="./balloons/buying/">
    <figure markdown="span">
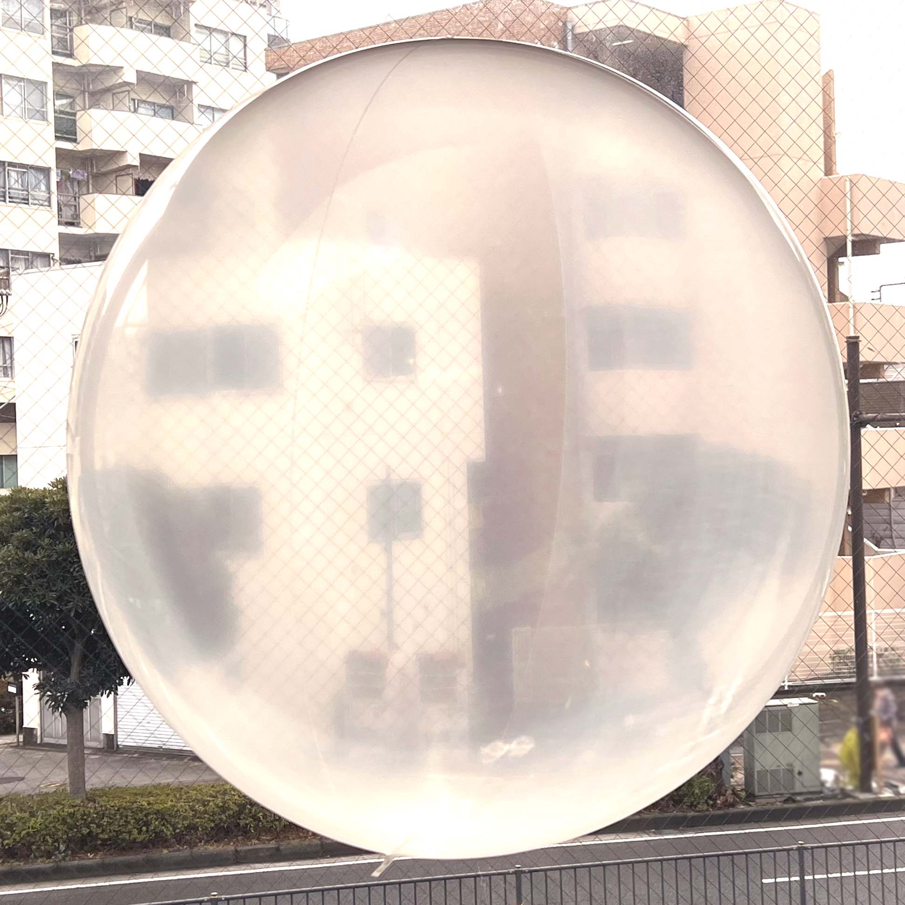
[picture p165: docs/faq/balloons/buying/balloon.jpg]
        
        <figcaption>Buying Balloons</figcaption>
    </figure>
  </a>

- <a class="card" href="./jlcpcb/">
    <figure markdown="span">
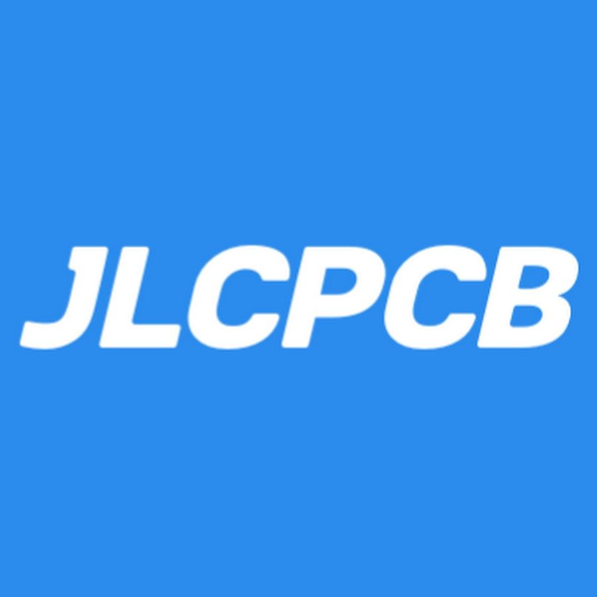
[picture p166: docs/faq/jlcpcb/jlcpcb_logo.jpg]
        
        <figcaption>Ordering from JLCPCB</figcaption>
    </figure>
  </a>

- <a class="card" href="./receiving/">
    <figure markdown="span">
        
        <figcaption>Setup WSPR Reception</figcaption>
    </figure>
  </a>

- <a class="card" href="./contact/">
    <figure markdown="span">
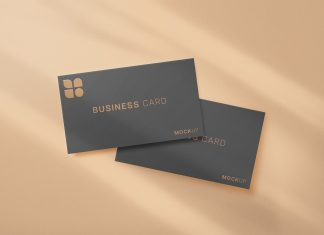
[picture p167: docs/faq/contact/card.jpg]
        
        <figcaption>Contact</figcaption>
    </figure>
  </a>

</div>
