traquito/traquito.github.io/docs/pro/telemetry/history/README.md

---
icon: material/history
---

# History

## Recognition

The Traquito technologies build on the contributions made by others that came before.

## Credit

Hans Summers designed the Channel scheme and U4B protocol and was later used in his tracker.

!!! note "U4B protocol is labeled Basic Telemetry on this site"
    The designation was given to highlight the the relationship of that data encoding to the Enhanced Telemetry subsequently introduced.

Pedro Converso runs the [LU7AA](http://lu7aa.org/wsprset.asp){:target="_blank"} tracking and registration website.

!!! quote "Sadly, Pedro is no longer with us [link](https://groups.io/g/picoballoon/topic/109625968#msg17162){:target="_blank"}"
    2024-11-17
    
    Hello everyone, today Pedro LU7ABF left us forever; we will remember him for inspiring us, for the work and research he did for Amsat Argentina and for his beloved Radio Club QRM Belgrano. Today he rests in peace. A sad Sunday for the entire amateur radio community.

    lu1esy

## Sites

To learn more about the relationship between different WSPR Pico Balloon sites, see the FAQ page on [Site Relationships](../../../faq/sites/README.md).
