traquito/traquito.github.io/(threads)

Thread 1 (2023-04-06):

Connecting to an already-connected device doesn't work but yields no error message explaining why

dmalnati, 2023-04-06:
Two windows, one already connected, the other attempts to connect.

Closed 2023-04-28.

Thread 14 (2023-04-28):

Weighted "average" of TX frequency

dmalnati, 2023-04-28:
Currently a sql query does the "averaging" which has issues, like the "average" frequency of a given channel, over long durations of time (to yield a count) changes depending on timeframe.  This isn't ideal.

Formalize the process of looking for spots, probably by acquiring the data yourself and weighting.

Possibly also increase resolution on a two-minute by two-minute basis in the query result.  Need to think about how to do weighting in that case.

Thread 5 (2023-04-28):

Plot frequency stability / drift against temperature, other factors

dmalnati, 2023-04-28:
