traquito/traquito.github.io/(list of files, drawings)

Other design files:
site/WOM5000/Wind-O-Matic 5000.fzz
