traquito/traquito.github.io/(commit log)

2023-04-13 ChannelSearch lu7aa use only current tracked channels
2023-04-17 flash from raspberry pi files
    [100ask-openjtag.cfg, 8devices-lima.cfg, actux3.cfg, adapteva_parallella1.cfg, adsp-sc584-ezbrd.cfg, alphascale_asm9260_ek.cfg, altera-10m50.cfg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]
2023-04-17 flash from pc files
    [100ask-openjtag.cfg, 8devices-lima.cfg, actux3.cfg, adapteva_parallella1.cfg, adsp-sc584-ezbrd.cfg, alphascale_asm9260_ek.cfg, altera-10m50.cfg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]
2023-04-17 whoops flash files were supposed to be under traquito repo
    [100ask-openjtag.cfg, 8devices-lima.cfg, actux3.cfg, adapteva_parallella1.cfg, adsp-sc584-ezbrd.cfg, alphascale_asm9260_ek.cfg, altera-10m50.cfg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]
2023-04-20 integration with device
2023-04-20 UI DeviceInfo; Debug cleanup
2023-04-20 Connection filter just Traquito
2023-04-21 Connection handles first-line garbage from device
2023-04-23 Traquito UI GPS power control
2023-04-24 WSPREncoded encoding fix for voltage and speed
2023-04-25 WSPREncoded round voltage and altitude instead of truncate
2023-04-29 fixes #17 (voltage encoding/decoding was wrong)
2023-05-11 dashboard graphs y-axis fixed range
2023-05-25 spot search dashboard makes channel optional, can track non-u4b trackers. fixes #21
2023-05-28 trackergui hides calibration slider now that search finds less precise tx. fixes #43
2023-06-16 trackergui now shows live temperature
2023-06-16 tracker power and antenna pad description/image
2023-06-18 tracker antenna notes
2023-06-18 tracker antenna notes typo fixed
2023-06-20 v1 tracker fab and firmware files
    [bom_jlcpcb.2023-06-20.csv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]
2023-06-21 tracker power source further clarification
2023-06-21 jlcpcb instructions say to use chrome since firefox and edge do not show gerbers right
2023-06-21 fixed up tracker gerbers
2023-06-22 hide tracker pcb files until jlcpcb issues sorted
2023-06-23 tracker page highlights pico cannot run .uf2 without add-on module soldered on
2023-06-27 trackergui remove 70cm and 23cm options as tracker cannot do it
2023-06-29 tracker page offers placement diagram for hand soldering
2023-07-01 clarify telemetry value ranges and clamping. disambiguate sentence that looks like geofencing
2023-07-03 tracker gps antenna guidance update. fixes #57
2023-07-10 solar page tweaks and gerber upload
2023-07-10 tracker 2023-07-10 software and hardware release
    [bom_jlcpcb.2023-07-10.csv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]
2023-07-13 DeviceInfoController configurable warning about api mode
2023-07-17 CharTimeSeries shows x-axis in tooltip since missing after tooltip
2023-07-18 tracker detail page clarifies voltage measurement is taken when GPS is on and loading the power source
2023-07-18 add rpi pico pcb layout image
2023-07-19 tracker specifies 70mA peak, not 60mA
2023-09-22 update tracker bom and cpl to avoid jlcpcb warnings, no functional change
    [bom_jlcpcb.2023-09-22.csv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]
2023-10-28 make search button work when there is a hash in the url
2023-11-11 solar solder demonstration
2023-11-11 solar demo now linkable via #solderdemo
2023-11-11 removing missed debug console print
2023-11-16 fingerprinting iteratively narrows threshold to reduce to single match
2024-01-01 Solar System Soldering Jig files
    [Solar_System_Soldering_Jig_2024-01-01.stl]
2024-01-01 solar system soldering jig page update
2024-01-30 Wind-O-Matic 5000
    [WOM5000.drum.2024-01-30.3mf, WOM5000.platform.2024-01-30.3mf, Wind-O-Matic 5000.fzz]
2024-07-08 force voltage to be 2 decimal places, fixes #74
2024-07-09 heat map prototype, commented out since not useful. fixes #79
2024-09-13 update tracker gerbers/bom/cpl with new crystal
    [bom_jlcpcb.2023-09-22.csv, bom_jlcpcb.2024-09-13.csv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]
2024-11-22 codec encoder generation working, getting ui ready for testing
2024-11-22 codec encoder seemingly working
2024-11-25 mkdocs structure change
    [Solar_System_Soldering_Jig_2024-01-01.stl, WOM5000.drum.2024-01-30.3mf, WOM5000.platform.2024-01-30.3mf, Wind-O-Matic 5000.fzz, bom_jlcpcb.2024-09-13.csv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]
2024-11-30 update static site
    [Solar_System_Soldering_Jig_2024-01-01.stl, WOM5000.drum.2024-01-30.3mf, WOM5000.platform.2024-01-30.3mf, Wind-O-Matic 5000.fzz, bom_jlcpcb.2024-09-13.csv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]
2024-12-02 add historical arduino lib site update
2024-12-03 update with links to Telemetry Steering Committee
2024-12-03 clarify user-defined can send in any/all HdrSlot slots (not type1 slot)
2024-12-04 extended telemetry playground accepts slot in input
2024-12-08 dashboard2 cleanup of pipeline structures and flow
2024-12-08 dashboard2 fingerprinting progress
2024-12-08 dashboard2 tightening up
2024-12-09 dashboard2 fingerprinting working
2024-12-10 Candidate filter logic moves to WsprMessageCandidate code
2024-12-10 Fingerprinting rejects all window slots if no anchor frequency in slot0
2024-12-14 WsprSearch now queries all slots
2024-12-14 dashboard configuration button work starting
2024-12-15 WsprSearchUiInputController has config box for slot field defs
2024-12-15 search ui limits height of slot field def configuration so it scrolls instead of falling off the page
2024-12-15 Base filters out blank url parameters
2024-12-15 WsprSearchUiInputController slot field def support
